lgitrt/tinyVario/results/altitude_error_comparison_standalone.png

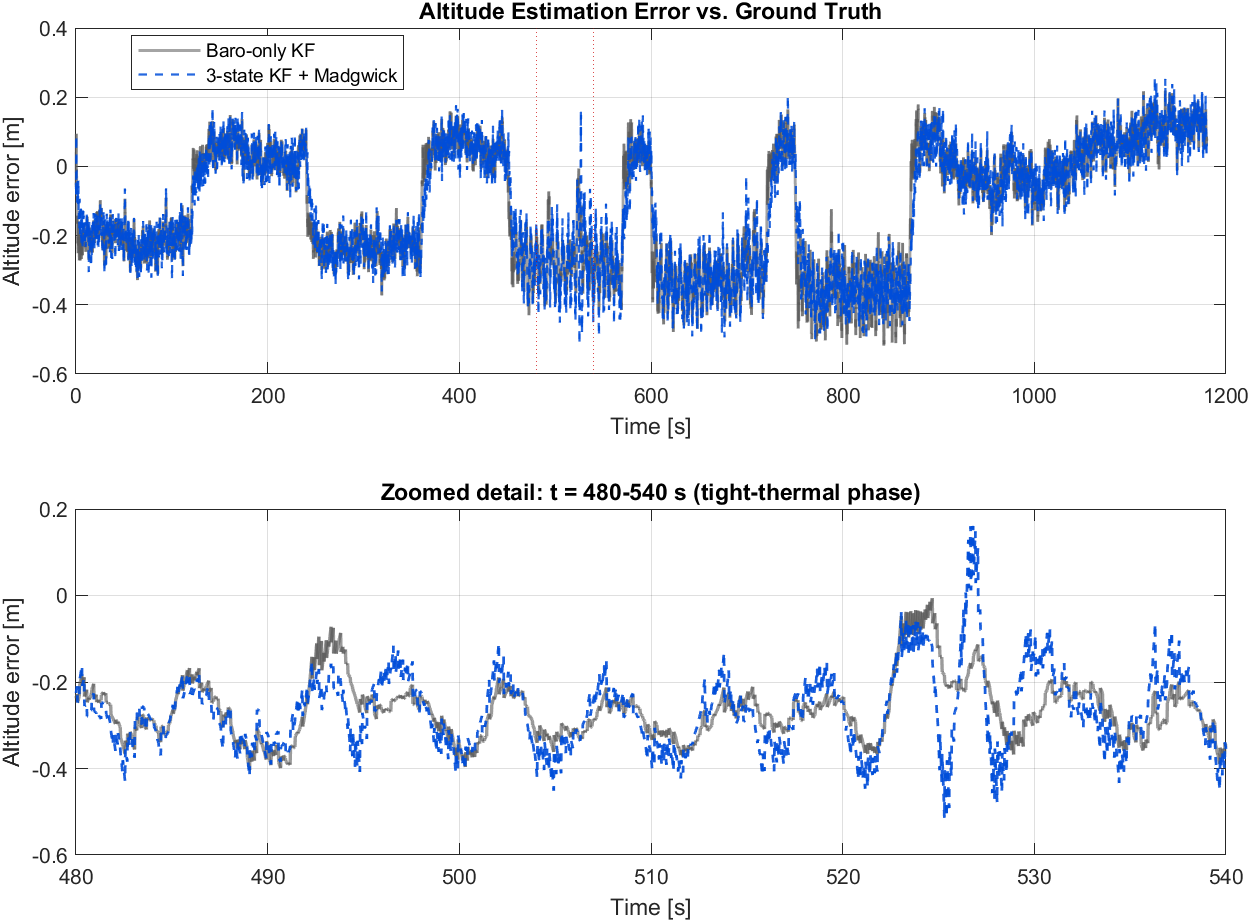
results/altitude_error_comparison_standalone.png
