lgitrt/tinyVario/results/az_world_estimate_standalone.png

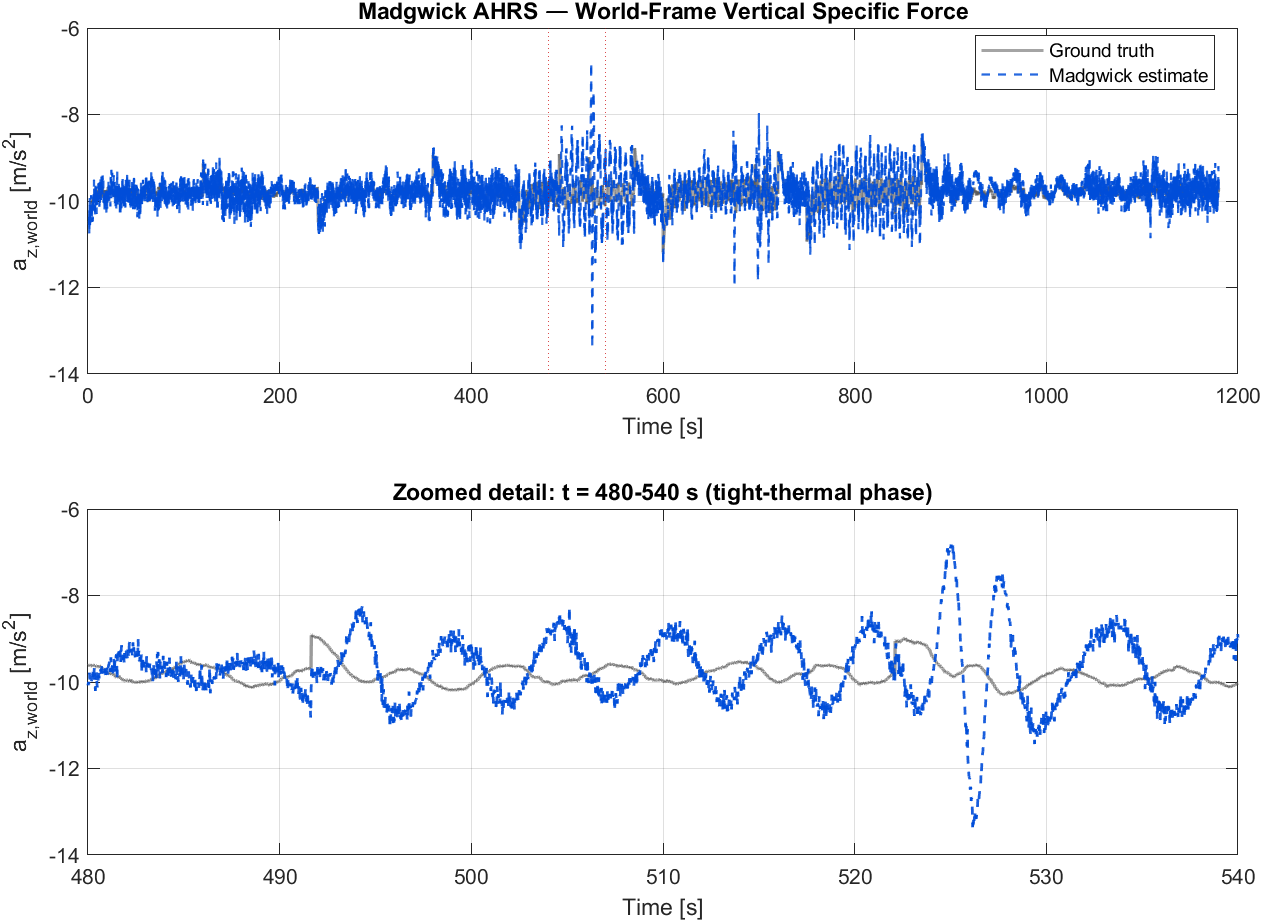
results/az_world_estimate_standalone.png
