lgitrt/tinyVario/results/vertical_speed_error_comparison_standalone.png

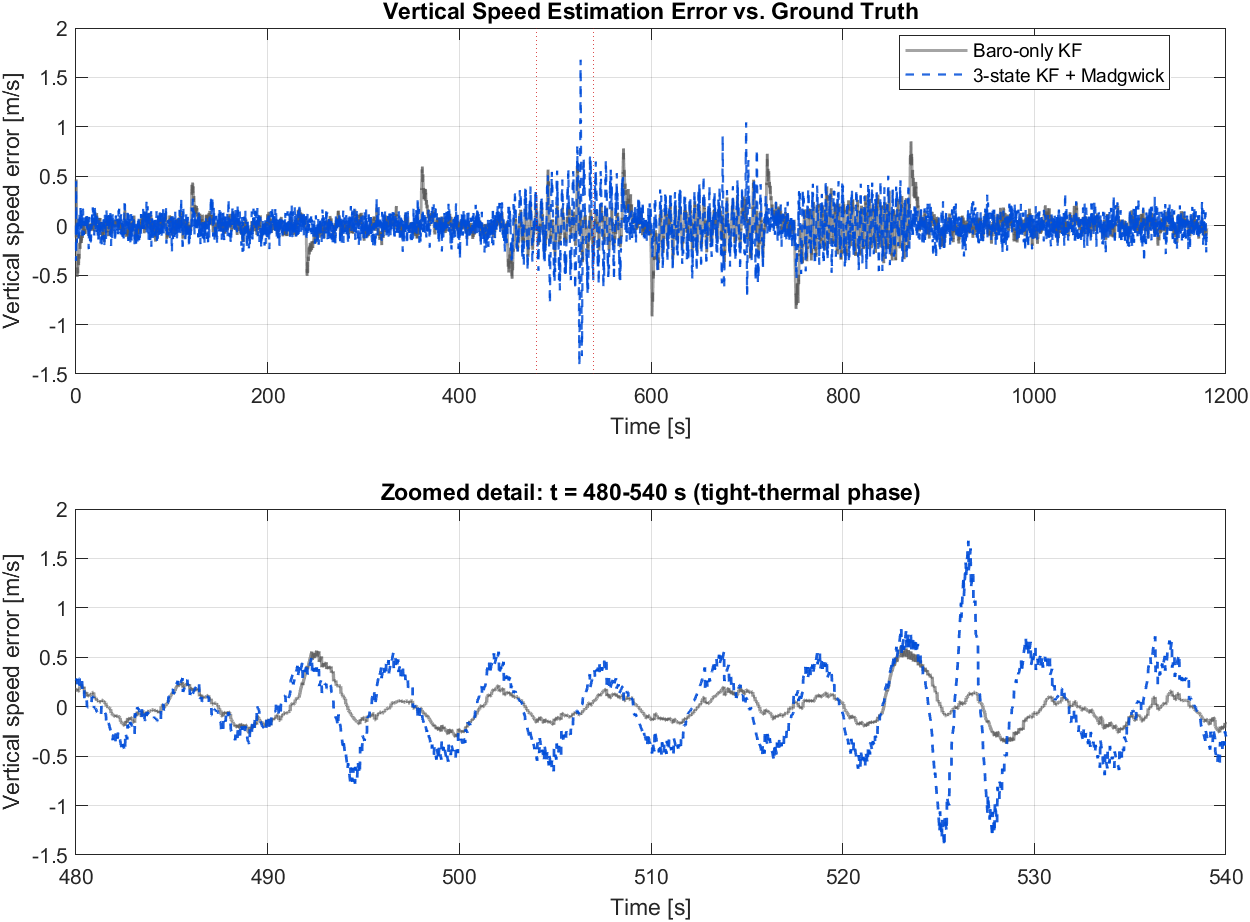
results/vertical_speed_error_comparison_standalone.png
