lgitrt/tinyVario/ElectronicsPlan/SCH_tinyVario_V1_Schematics_2026-08-13.pdf

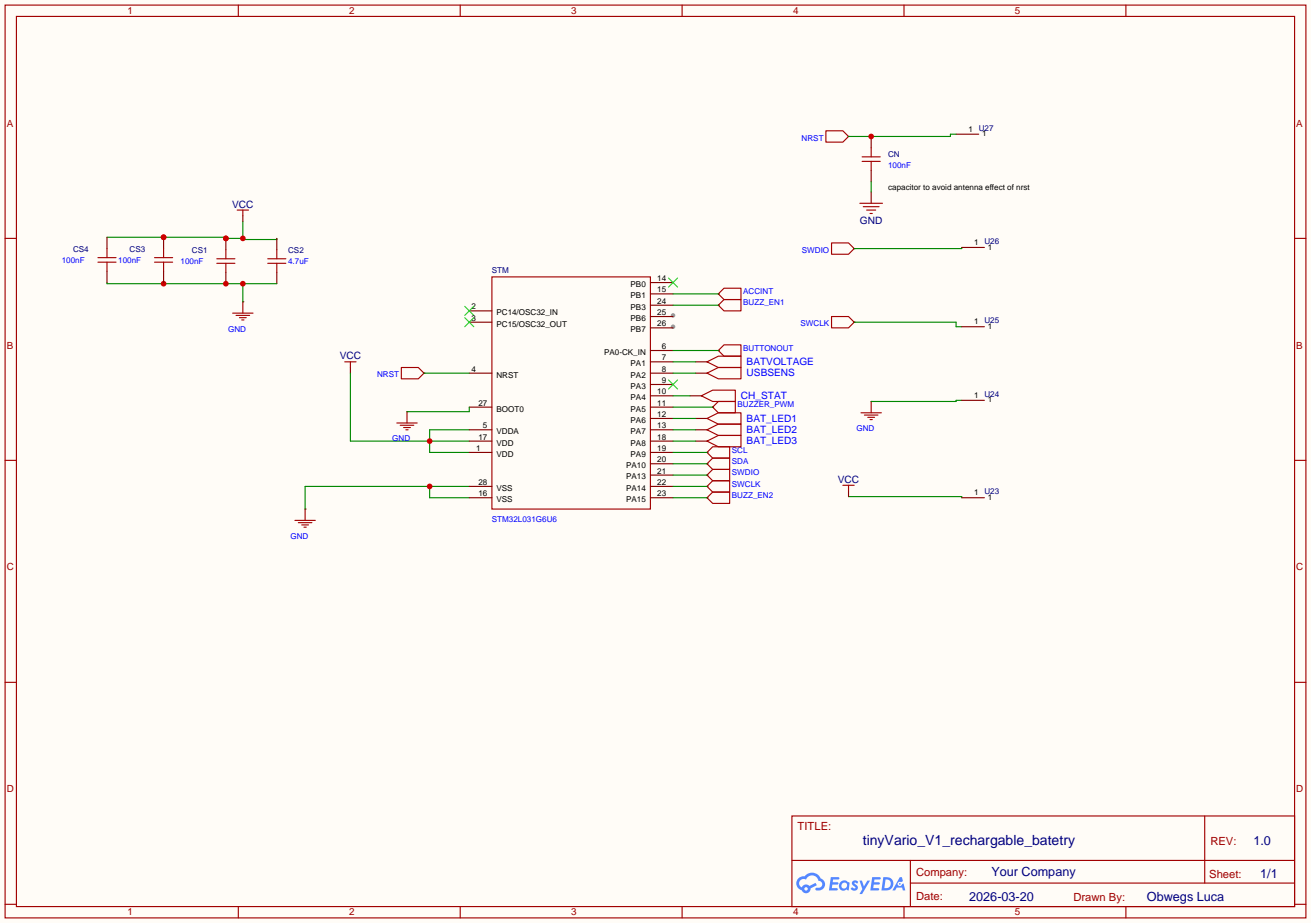
[picture p8: page 1]

capacitor to avoid antenna effect of nrst

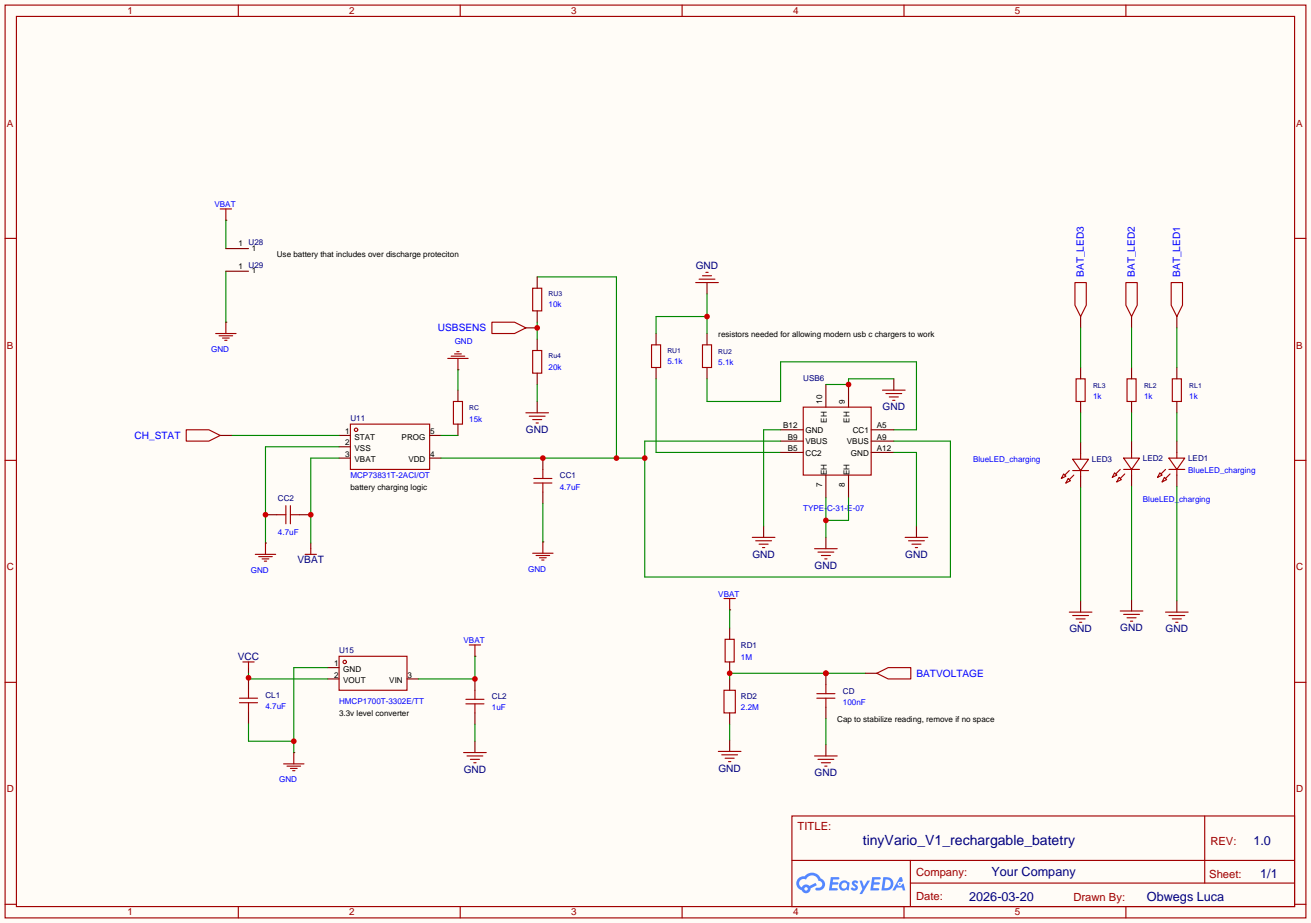
[picture p9: page 2]

Cap to stabilize reading, remove if no space

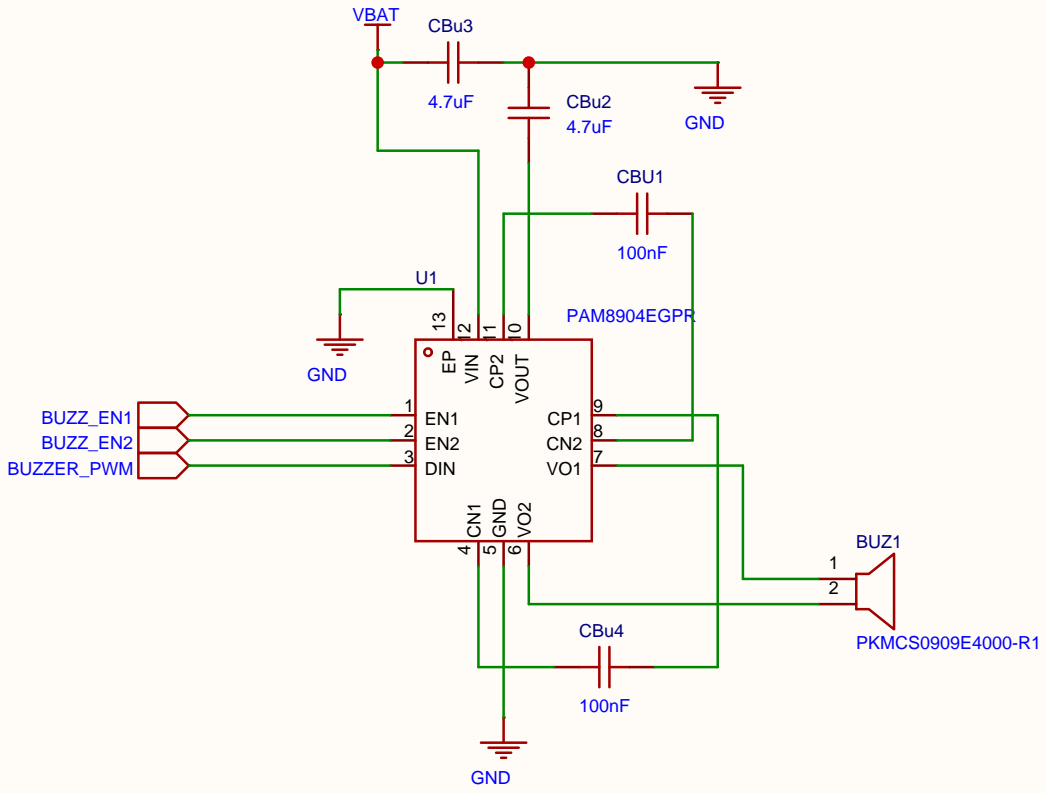
[picture p10: page 3]

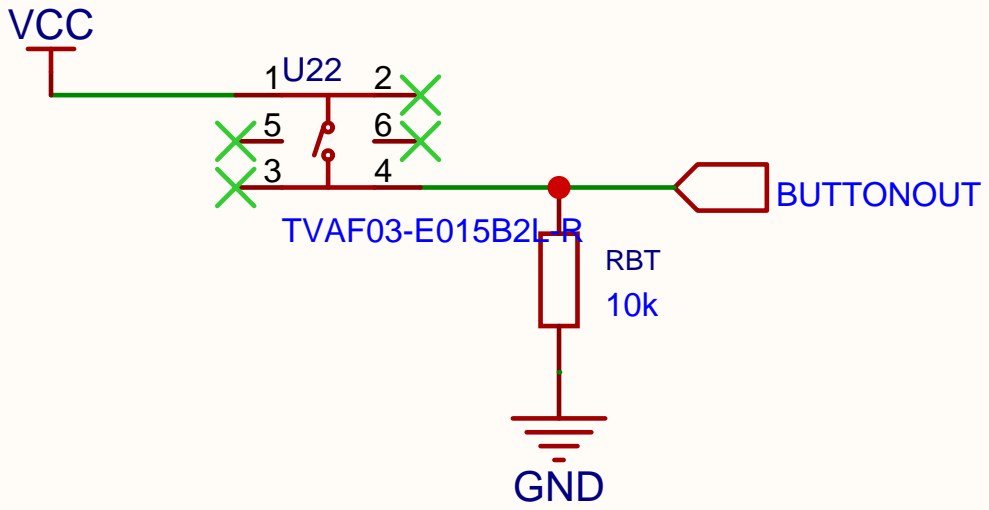
[picture p11: page 4]

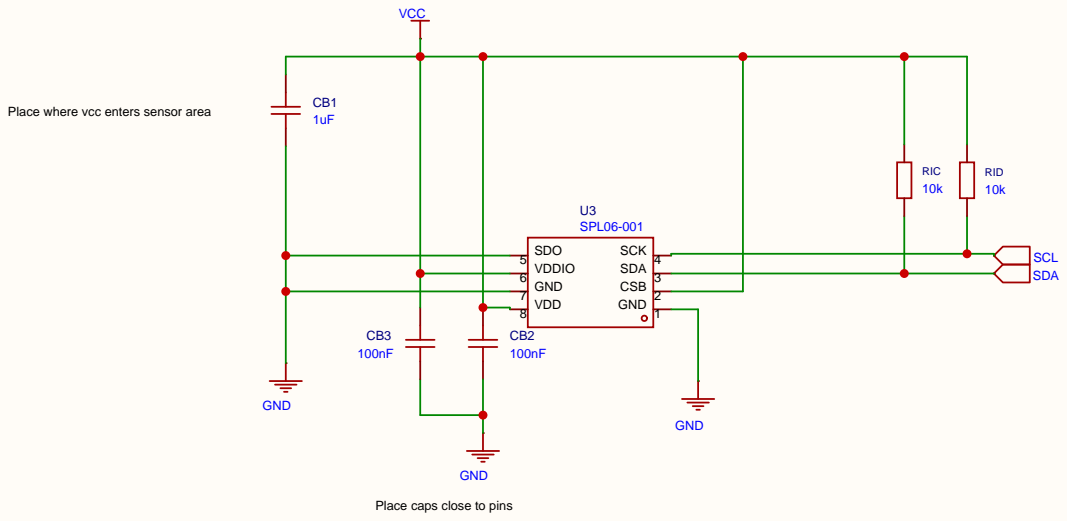
[picture p12: page 5]

Place where vcc enters sensor area

Place caps close to pins

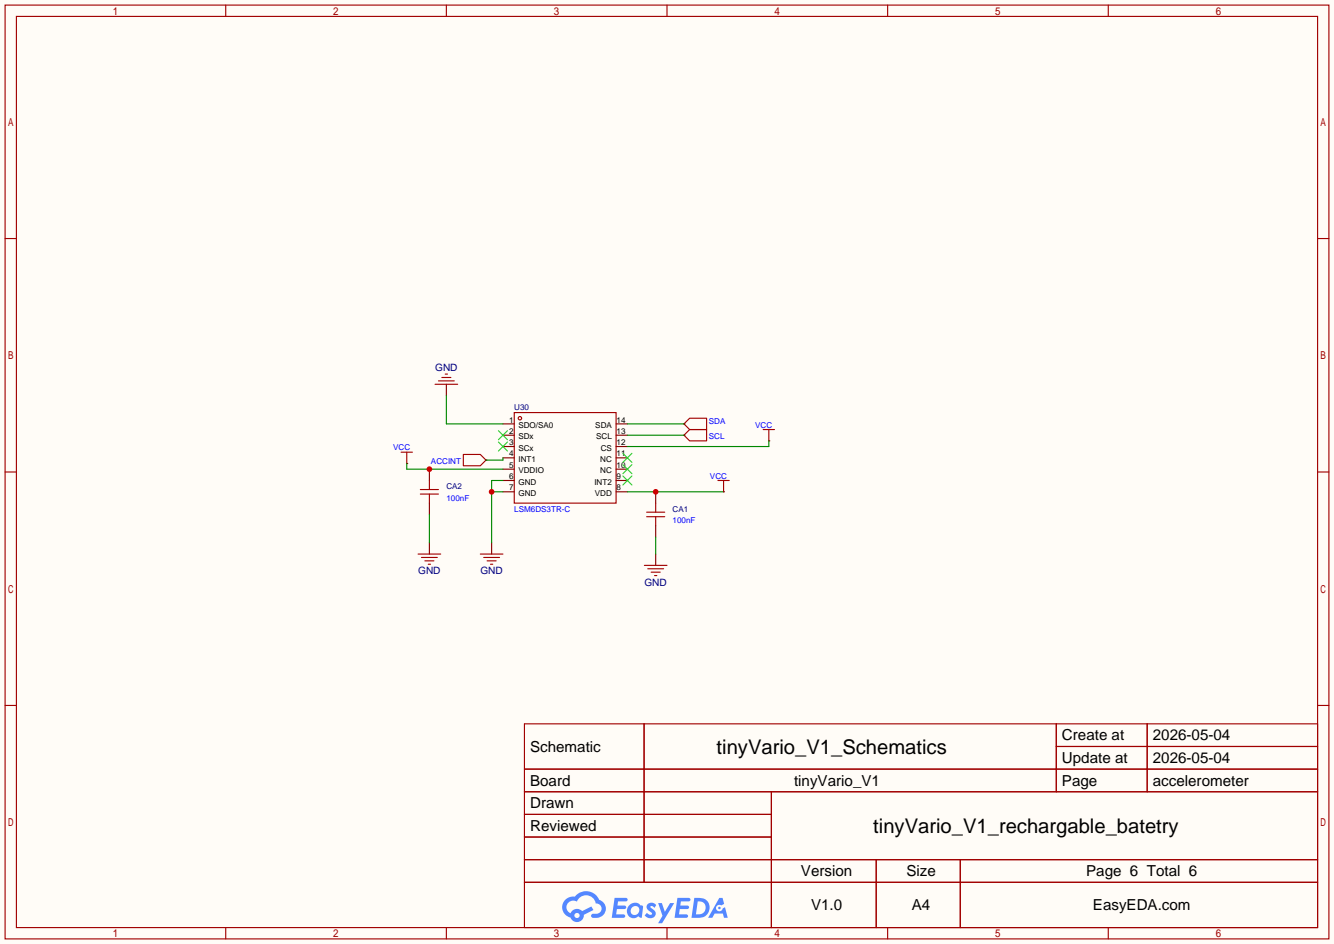
[picture p13: page 6]

NC 10 NC 11 CS 12 SCL 13 SDA 14

Schematic | tinyVario_V1_Schematics | Create at | 2026-05-04

Update at | 2026-05-04

Board | tinyVario_V1 | Page | accelerometer
Drawn | | tinyVario_V1_rechargable_batetry
Reviewed

Version | Size | Page 6 Total 6
V1.0 | A4 | EasyEDA.com
