lgitrt/tinyVario/Core/Src/main.c

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
/* Includes ------------------------------------------------------------------*/
#include "main.h"

/* USER CODE BEGIN Includes */
#include "led.h"
#include "battery.h"
#include "button.h"
#include "buzzer.h"
#include "vario.h"
/* USER CODE END Includes */

ADC_HandleTypeDef hadc;

I2C_HandleTypeDef hi2c1;
DMA_HandleTypeDef hdma_i2c1_rx;

TIM_HandleTypeDef htim2;
TIM_HandleTypeDef htim21;

/* USER CODE BEGIN PV */
volatile SystemError_t g_system_error = ERR_UNKNOWN;
static uint8_t initial_turn_on_released = 0;
SystemState_t current_state = STATE_OFF;
static uint32_t vbat = 0;
volatile uint8_t battery_soc_pct = 0;
static uint8_t stall_count = 0;  /* consecutive IMU stall events; reboot at threshold */
static uint32_t last_batt_check_tick = 0;
/* USER CODE END PV */

void SystemClock_Config(void);
static void MX_GPIO_Init(void);
static void MX_DMA_Init(void);
static void MX_ADC_Init(void);
static void MX_I2C1_Init(void);
static void MX_TIM2_Init(void);
static void MX_TIM21_Init(void);
/**
  * @brief  The application entry point.
  * @retval int
  */
int main(void)
{

  /* MCU Configuration--------------------------------------------------------*/

  /* Reset of all peripherals, Initializes the Flash interface and the Systick. */
  HAL_Init();

  /* Configure the system clock */
  SystemClock_Config();

  /* USER CODE BEGIN SysInit */
  // Keep SWD clocks running during Standby and Stop modes for debugging ---> REMOVE IN PRODUCTION CODE
  HAL_DBGMCU_EnableDBGStandbyMode();
  HAL_DBGMCU_EnableDBGStopMode();
  /* IWDG runs in standby; if it fired while sleeping re-enter standby silently (no LED animation) */
  if (RCC->CSR & RCC_CSR_IWDGRSTF) {
      RCC->CSR |= RCC_CSR_RMVF;                     /* clear all reset flags */
      __HAL_PWR_CLEAR_FLAG(PWR_FLAG_WU);
      HAL_PWR_EnableWakeUpPin(PWR_WAKEUP_PIN1);
      HAL_PWR_EnableWakeUpPin(PWR_WAKEUP_PIN3);
      IWDG->KR = 0xAAAA;                             /* pet before re-entering standby */
      HAL_PWR_EnterSTANDBYMode();
      while (1);                                     /* unreachable; satisfies compiler */
  }
  /* IWDG: ~26 s hardware watchdog — automatic reboot if firmware freezes for any reason.
     LSI ~37 kHz / prescaler-256 / reload-4095 ≈ 28 s (worst-case 47 kHz ≈ 22 s). */
  IWDG->KR = 0xCCCC;                  /* start IWDG */
  IWDG->KR = 0x5555;                  /* unlock PR/RLR registers */
  IWDG->PR = 6; IWDG->RLR = 0x0FFF;  /* /256 prescaler, max reload 4095 */
  while (IWDG->SR & 0x3);             /* wait for registers to update */
  IWDG->KR = 0xAAAA;                  /* reload — countdown starts */
  /* USER CODE END SysInit */

  /* Initialize all configured peripherals */
  MX_GPIO_Init();
  MX_DMA_Init();
  MX_ADC_Init();
  MX_I2C1_Init();
  MX_TIM2_Init();
  MX_TIM21_Init();
  Battery_Load_State_From_EEPROM();
  /* USER CODE BEGIN 2 */
  /* 1. Check whether the button was held for the full power-on gesture (2 s) */
  if (Is_Button_Held_2s()) {
    current_state = STATE_ACTIVE;
    initial_turn_on_released = 0; // lock out shutdown until the finger is lifted once

    /* --- Turn-on animation: LEDs light up one after another --- */
    HAL_GPIO_WritePin(GPIOA, BATled1_Pin, GPIO_PIN_SET);
    HAL_Delay(250);
    HAL_GPIO_WritePin(GPIOA, BATled2_Pin, GPIO_PIN_SET);
    HAL_Delay(250);
    HAL_GPIO_WritePin(GPIOA, BATled3_Pin, GPIO_PIN_SET);
    HAL_Delay(400); // brief pause so the user registers that all 3 are lit

    /* --- Battery level readout, shown for ~3 s --- */
    vbat = Read_Battery_MV();
    battery_soc_pct = Battery_Get_Fused_SOC(vbat, 25);

    if (vbat <= BAT_SHUTDOWN_MV) {
      /* Battery is already critical at power-on: skip the normal level display and
         don't start the sensors, buzzer, or IMU interrupt at all. Flash the warning
         LED and fall through to a clean shutdown; sensors_initialized stays 0, so
         STATE_OFF below skips sensor standby. */
      HAL_GPIO_WritePin(GPIOA, BATled1_Pin | BATled2_Pin | BATled3_Pin, GPIO_PIN_RESET);
      Handle_Critical_Battery();
    } else {
      /* Only turn off whichever LEDs don't belong at this SOC level - the ones that do
         belong just stay lit from the turn-on animation, so there's no off/on flicker. */
      Display_Battery_Level_Static(battery_soc_pct);
      HAL_Delay(3000);
      HAL_GPIO_WritePin(GPIOA, BATled1_Pin | BATled2_Pin | BATled3_Pin, GPIO_PIN_RESET);

      /* 2. Initialize sensors */
      if (SPL06_Init(&hi2c1) != HAL_OK) {
        HALT_WITH_ERROR(ERR_BARO_SPL06);
      }
      dbg_spl06_active = 1;

      if (LSM6DS3_Init(&hi2c1) != HAL_OK) {
        HALT_WITH_ERROR(ERR_IMU_LSM6DS3);
      }
      dbg_imu_active = 1;

      /* 3. Clear latched IMU interrupts */
      uint8_t dummy_buf[12];
      for (uint8_t i = 0; i < 3; i++) {
        LSM6DS3_ReadRaw_Poll(&hi2c1, dummy_buf);
        HAL_Delay(10);
      }

      /* 4. Barometer stabilization */
      HAL_Delay(100);
      SPL06_GetTemperature(&hi2c1); // populate calib.last_t_raw_sc first
      reference_pressure_pa = SPL06_GetPressure(&hi2c1);

      /* 5. Start PWM for the buzzer */
      HAL_TIM_PWM_Start(&htim2, TIM_CHANNEL_1);
      __HAL_TIM_SET_COMPARE(&htim2, TIM_CHANNEL_1, 0);
      g_volume = Load_Volume();
      Set_Volume(g_volume);

      /* 5b. Start TIM21 as a free-running timestamp counter for IMU dt measurement */
      HAL_TIM_Base_Start(&htim21);

      /* 6. Arm the EXTI interrupt */
      HAL_NVIC_EnableIRQ(EXTI0_1_IRQn);

      /* Seed the stall watchdog so it doesn't fire immediately on entry */
      last_imu_sample_tick = HAL_GetTick();
    }
  } else if (HAL_GPIO_ReadPin(USB_PORT, USB_PIN) == GPIO_PIN_SET) {
    current_state = STATE_CHARGING; // USB plugged in at boot, button not held
  } else {
    current_state = STATE_OFF;
  }
  /* USER CODE END 2 */

  /* Infinite loop */
  /* USER CODE BEGIN WHILE */
  while (1)
  {
    switch (current_state) {
      case STATE_OFF:
        if (HAL_GPIO_ReadPin(USB_PORT, USB_PIN) == GPIO_PIN_SET) {
          current_state = STATE_CHARGING;
          break; // skip the standby-entry code below this cycle
        }

        /* 1. Shut down audio, interrupts, and LEDs immediately at t = 2.0 s */
        HAL_NVIC_DisableIRQ(EXTI0_1_IRQn);
        HAL_NVIC_DisableIRQ(DMA1_Channel2_3_IRQn);
        HAL_TIM_PWM_Stop(&htim2, TIM_CHANNEL_1);
        Set_Volume(0); // shut down PAM8904

        if (sensors_initialized) {
          if (!Sensors_Safe_Shutdown()) {
            /* Couldn't confirm both sensors are powered down even after retries and a
               bus reset - make this visible instead of silently going to Standby with a
               sensor possibly still drawing current. Distinct pattern from the
               low-battery warning so it's identifiable on the bench. */
            for (uint8_t i = 0; i < 6; i++) {
              HAL_GPIO_TogglePin(GPIOA, BATled1_Pin | BATled3_Pin);
              HAL_Delay(150);
            }
            HAL_GPIO_WritePin(GPIOA, BATled1_Pin | BATled2_Pin | BATled3_Pin, GPIO_PIN_RESET);
          }
          HAL_I2C_DeInit(&hi2c1); // releases I2C clock, DMA channel, and PA9/PA10 AF pins
        }

        /* --- Turn-off animation --- */
        HAL_GPIO_WritePin(GPIOA, BATled1_Pin | BATled2_Pin | BATled3_Pin, GPIO_PIN_SET);
        HAL_Delay(1000);
        HAL_GPIO_WritePin(GPIOA, BATled1_Pin | BATled2_Pin | BATled3_Pin, GPIO_PIN_RESET);

        /* 2. Wait silently for physical release so Standby hardware doesn't instant-reboot */
        while (HAL_GPIO_ReadPin(BUTTON_PORT, BUTTON_PIN) == GPIO_PIN_SET) {
          HAL_Delay(10);
        }

        /* 3. Debounce: wait 100 ms for mechanical switch bouncing to fully settle */
        HAL_Delay(100);

        /* Remove the pull-up on INT1 - ~82 uA flows through it in Standby when the pin is driven low */
        {
          GPIO_InitTypeDef g = {0};
          g.Pin  = acc_INT_Pin;
          g.Mode = GPIO_MODE_INPUT;
          g.Pull = GPIO_NOPULL;
          HAL_GPIO_Init(acc_INT_GPIO_Port, &g);
        }

        /* USB hot-plugged during the shutdown animation - skip Standby */
        if (HAL_GPIO_ReadPin(USB_PORT, USB_PIN) == GPIO_PIN_SET) {
          current_state = STATE_CHARGING;
          break;
        }

        /* 4. Clear the wake-up flag and enter Standby mode */
        __HAL_PWR_CLEAR_FLAG(PWR_FLAG_WU);
        HAL_PWR_EnableWakeUpPin(PWR_WAKEUP_PIN1);
        HAL_PWR_EnableWakeUpPin(PWR_WAKEUP_PIN3);

        IWDG->KR = 0xAAAA; /* pet before standby - full ~26 s before next reset */
        dbg_mcu_state = DBG_MCU_STANDBY;
        HAL_PWR_EnterSTANDBYMode();
        /* If we reach this line, standby entry failed (pending wake-up flag or mis-configuration) */
        dbg_standby_fail++;
        dbg_mcu_state = DBG_MCU_ACTIVE;
        break;

      case STATE_ACTIVE:
        /* --- Shutdown timing (bypass STOP mode while the button is held) --- */
        if (HAL_GPIO_ReadPin(BUTTON_PORT, BUTTON_PIN) == GPIO_PIN_SET) {
          if (initial_turn_on_released) {
            /* Silence the buzzer immediately so it doesn't hang mid-tone for the whole
               2 s hold - stop as soon as the press starts. */
            Set_Buzzer_Frequency(0);
            is_beeping = 0;

            uint32_t press_start = HAL_GetTick();

            /* Trap execution here so the MCU stays awake to count ticks normally */
            uint8_t consec_low = 0;
            while (1) {
              HAL_Delay(10);
              if (HAL_GPIO_ReadPin(BUTTON_PORT, BUTTON_PIN) == GPIO_PIN_SET) {
                consec_low = 0;
                if ((HAL_GetTick() - press_start) >= 2000) {
                  current_state = STATE_OFF;
                  break;
                }
              } else {
                /* Require 50 ms of sustained release to guard against buzzer-induced bounce */
                if (++consec_low >= 5) break;
              }
            }
            if (current_state != STATE_OFF) {
              /* Short press: cycle volume 1 -> 2 -> 3 -> 1 */
              g_volume = (g_volume % 3) + 1;
              Set_Volume(g_volume);
              if (Save_Volume(g_volume) != EEPROM_SETTINGS_OK) {
                HALT_WITH_ERROR(ERR_EEPROM_STORAGE);
              }
              Display_Volume_LED(g_volume);
              last_imu_sample_tick = HAL_GetTick(); // prevent stall watchdog after the 1 s block
            }
          }
        } else {
          /* Button was completely released, arm the system for a future power-off hold */
          initial_turn_on_released = 1;
        }

        /* If the inner loop triggered a state change to OFF, jump out of this switch case instantly */
        if (current_state == STATE_OFF) {
          break;
        }

        /* --- Battery monitoring (every ~2 s - no need to sample at the 26 Hz IMU rate) ---
           Sample only when the system is quiescent enough that the regulator and sensor
           load are not biasing the battery divider measurement. */
        if ((HAL_GetTick() - last_batt_check_tick) >= BATT_CHECK_INTERVAL_MS) {
          last_batt_check_tick = HAL_GetTick();
          vbat = Battery_Read_MV_Quiescent();
          Battery_Update_Estimate(vbat);
          int32_t batt_temp_c = 25;
          if (sensors_initialized) {
            batt_temp_c = SPL06_GetTemperature(&hi2c1) / 1000;
          }
          battery_soc_pct = Battery_Get_Fused_SOC(vbat, batt_temp_c);

          if (vbat <= BAT_SHUTDOWN_MV) {
            Handle_Critical_Battery();
            break; // let STATE_OFF take over on the next loop iteration
          }
        }

        /* --- Main vario logic --- */
        if (imu_data_ready) {
          imu_data_ready = 0;
          last_imu_sample_tick = HAL_GetTick();
          stall_count = 0;
          IWDG->KR = 0xAAAA; /* pet the watchdog on every healthy IMU sample */
          Process_Vario_Math();
        } else if ((HAL_GetTick() - last_imu_sample_tick) > IMU_STALL_TIMEOUT_MS) {
          /* No IMU sample for far longer than the ~19 ms expected at 26 Hz - the I2C/DMA
             pipeline (or the sensor's INT1 line) is wedged. Reset the bus and sensor
             configuration instead of sitting silently until the user power-cycles. */
          if (++stall_count >= 5) NVIC_SystemReset(); // 5 consecutive stalls = ~2.5 s without data
          Recover_IMU_Bus();
        }

        /* Low-power sleep between samples */
        dbg_mcu_state = DBG_MCU_SLEEP;
        HAL_PWR_EnterSLEEPMode(PWR_MAINREGULATOR_ON, PWR_SLEEPENTRY_WFI);
        dbg_mcu_state = DBG_MCU_ACTIVE;
        break;

      case STATE_CHARGING:
        /* --- Charging mode (stay awake) --- */
        IWDG->KR = 0xAAAA; /* pet the watchdog */

        vbat = Battery_Read_MV_Quiescent();
        Battery_Update_Estimate(vbat);
        int32_t batt_temp_c = 25;
        if (sensors_initialized) {
          batt_temp_c = SPL06_GetTemperature(&hi2c1) / 1000;
        }
        battery_soc_pct = Battery_Get_Fused_SOC(vbat, batt_temp_c);
        Display_Charging_Status(battery_soc_pct); // keep LEDs flashing/solid based on SOC

        /* Exit if USB is unplugged */
        if (HAL_GPIO_ReadPin(USB_PORT, USB_PIN) == GPIO_PIN_RESET) {
          current_state = STATE_OFF;
        }

        /* If the user holds the button for 2 s while charging, switch to vario mode */
        if (HAL_GPIO_ReadPin(BUTTON_PORT, BUTTON_PIN) == GPIO_PIN_SET) {
          uint32_t press_start = HAL_GetTick();
          while (HAL_GPIO_ReadPin(BUTTON_PORT, BUTTON_PIN) == GPIO_PIN_SET) {
            if ((HAL_GetTick() - press_start) > 2000) {
              current_state = STATE_ACTIVE;
              break;
            }
            HAL_Delay(10);
          }
        }
        HAL_Delay(50); // fast response for the button check
        break;
    }
  /* USER CODE END WHILE */

    /* USER CODE BEGIN 3 */
  }
  /* USER CODE END 3 */
}

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
