lgitrt/tinyVario/Core/Inc/main.h

#define ButtonIn_Pin GPIO_PIN_0
#define ButtonIn_GPIO_Port GPIOA
#define BATvoltage_Pin GPIO_PIN_1
#define BATvoltage_GPIO_Port GPIOA
#define USBsens_Pin GPIO_PIN_2
#define USBsens_GPIO_Port GPIOA
#define CHstat_Pin GPIO_PIN_4
#define CHstat_GPIO_Port GPIOA
#define BuzzerPWM_Pin GPIO_PIN_5
#define BuzzerPWM_GPIO_Port GPIOA
#define BATled1_Pin GPIO_PIN_6
#define BATled1_GPIO_Port GPIOA
#define BATled2_Pin GPIO_PIN_7
#define BATled2_GPIO_Port GPIOA
#define acc_INT_Pin GPIO_PIN_1
#define acc_INT_GPIO_Port GPIOB
#define acc_INT_EXTI_IRQn EXTI0_1_IRQn
#define BATled3_Pin GPIO_PIN_8
#define BATled3_GPIO_Port GPIOA
#define BUZ_EN2_Pin GPIO_PIN_15
#define BUZ_EN2_GPIO_Port GPIOA
#define BUZ_EN1_Pin GPIO_PIN_3
#define BUZ_EN1_GPIO_Port GPIOB
