lgitrt/tinyVario/(commit log)

2026-10-01 Add firmware source, drivers, and hardware design
    Complete STM32CubeIDE project for tinyVario, a paragliding variometer
    built around an STM32L031G6 (Cortex-M0+):
    - Core/: application firmware (sensor fusion, power management, audio,
    UI) plus STM32CubeMX-generated HAL/startup code. Every hand-written
    module (madgwick.c, kalman_vz.c, vario.c, battery.c, button.c,
    buzzer.c, led.c, lsm6ds3.c, spl06.c and their headers) is attributed
    to its author and kept clearly separated from CubeMX-generated
    boilerplate via the standard USER CODE markers.
    - Drivers/: CMSIS and STM32L0 HAL (vendor-generated).
    - ElectronicsPlan/: PCB schematics and netlist for the custom 4-layer
    board.
    - simulation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
    [LiftSenseMiniV3.ioc, battery.c, battery.h, button.c, button.h, buzzer.c, buzzer.h, filter_tuning.h]
2026-10-01 Add host-side unit tests and CI workflow
    madgwick.c and kalman_vz.c have no HAL/MCU dependencies, so they can be
    tested on the host with plain gcc, no ARM toolchain or hardware
    required. Tests link the real firmware source directly (no mocks):
    - test_madgwick.c: rest/tilted-initialization orientation checks, a
    sustained-rotation normalization regression guard, and an
    accelerometer-gate fault-injection test.
    - test_kalman_vz.c: convergence-to-rest, exact-kinematics check against
    closed-form integration, zero-velocity-update reset, and a
    barometer-outlier gate fault-injection test.
    - tests/Makefile: make -C tests test builds and runs both suites,
    written to work the same way under P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
    [test_kalman_vz.c, test_madgwick.c, test_util.h]
2026-10-01 Rewrite README with project overview and build/test instructions
    Replace the placeholder README with a full project page: motivation,
    engineering highlights, hardware table, firmware architecture and
    filter-pipeline diagrams, build instructions, a testing section
    documenting the new unit test suite and CI badge, and author/license
    info.
2026-10-01 Stop tracking the local-only simulation/ folder
    The Simulink/Simscape Multibody model and its large CAD assets were
    never meant to be published (too large for plain git, and not needed to
    validate the filter math); remove it from the index while keeping it on
    disk, and add simulation/ to .gitignore so it is not re-added by
    accident. The MATLAB reference functions it depends on remain published
    under Core/Src/matlab_functions/, and a Simulink-free validation harness
    is added separately under matlab/.
2026-10-01 Add accel-magnitude gate to fcn_madgwick.m; add MATLAB validation harness
    fcn_madgwick.m (the MATLAB reference the C code was translated from) was
    missing the accelerometer-magnitude gate that Core/Src/madgwick.c
    actually ships with (MADGWICK_ACCEL_GATE_FRAC in filter_tuning.h): the
    gradient correction must be skipped whenever |a| deviates too far from g,
    or sustained kinematic acceleration during turns/wingovers corrupts the
    attitude estimate. Port the same gate into the MATLAB function so both
    implementations match; found while building a standalone validation
    script for this exact file.
    Add matlab/, a toolbox-free MATLAB harness that exercises the shared
    fcn_madgwick.m / fcn_kalman_vz.m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
2026-10-01 Rename all LiftSense references to tinyVario
    Rename the STM32CubeIDE project (.project/.cproject), the .ioc and
    .launch files, and the schematic PDF/netlist in ElectronicsPlan/ to
    drop the old LiftSense/LiftSenseMini project name, since the project
    has been renamed to tinyVario. Also updates the main.c copyright line
    and remaining README mentions.
    The schematic PDF's embedded title-block text and bookmark titles were
    edited in place (via pikepdf) rather than just renaming the file, so no
    trace of the old name remains in its content either.
2026-10-01 Improve plot readability and document simulated flight model
    - Redraw all three filter-comparison plots (az_world, altitude error,
    vertical speed error) with semi-transparent, distinctly-styled lines
    plus a zoomed-in inset over a dynamic tight-thermal window, so the
    near-identical baro-only vs. 3-state KF traces no longer fully occlude
    each other.
    - Add a trajectory overview plot (altitude, attitude, IMU accel, ground
    track) captured from trajectory_paraglider.m's diagnostic figure.
    - Apply the same readability fix to the local-only Simulink plotting
    script and regenerate the published (non-standalone) result plots.
    - Document the synthetic flight model's simulated effects in the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
2026-10-06 Separate EEPROM settings with versioned CRC records
    Prevent battery and volume storage collisions, validate persisted records and report write failures; add host regressions and clarify production filter and battery model scope.
    [battery.c, battery.h, buzzer.c, buzzer.h, eeprom_settings.c, eeprom_settings.h, filter_tuning.h, kalman_vz.c]
